mneuroth/PicoHomeComputer/Documentation/README.md

# Documentation of the PicoHomeComputer

Schematical diagram

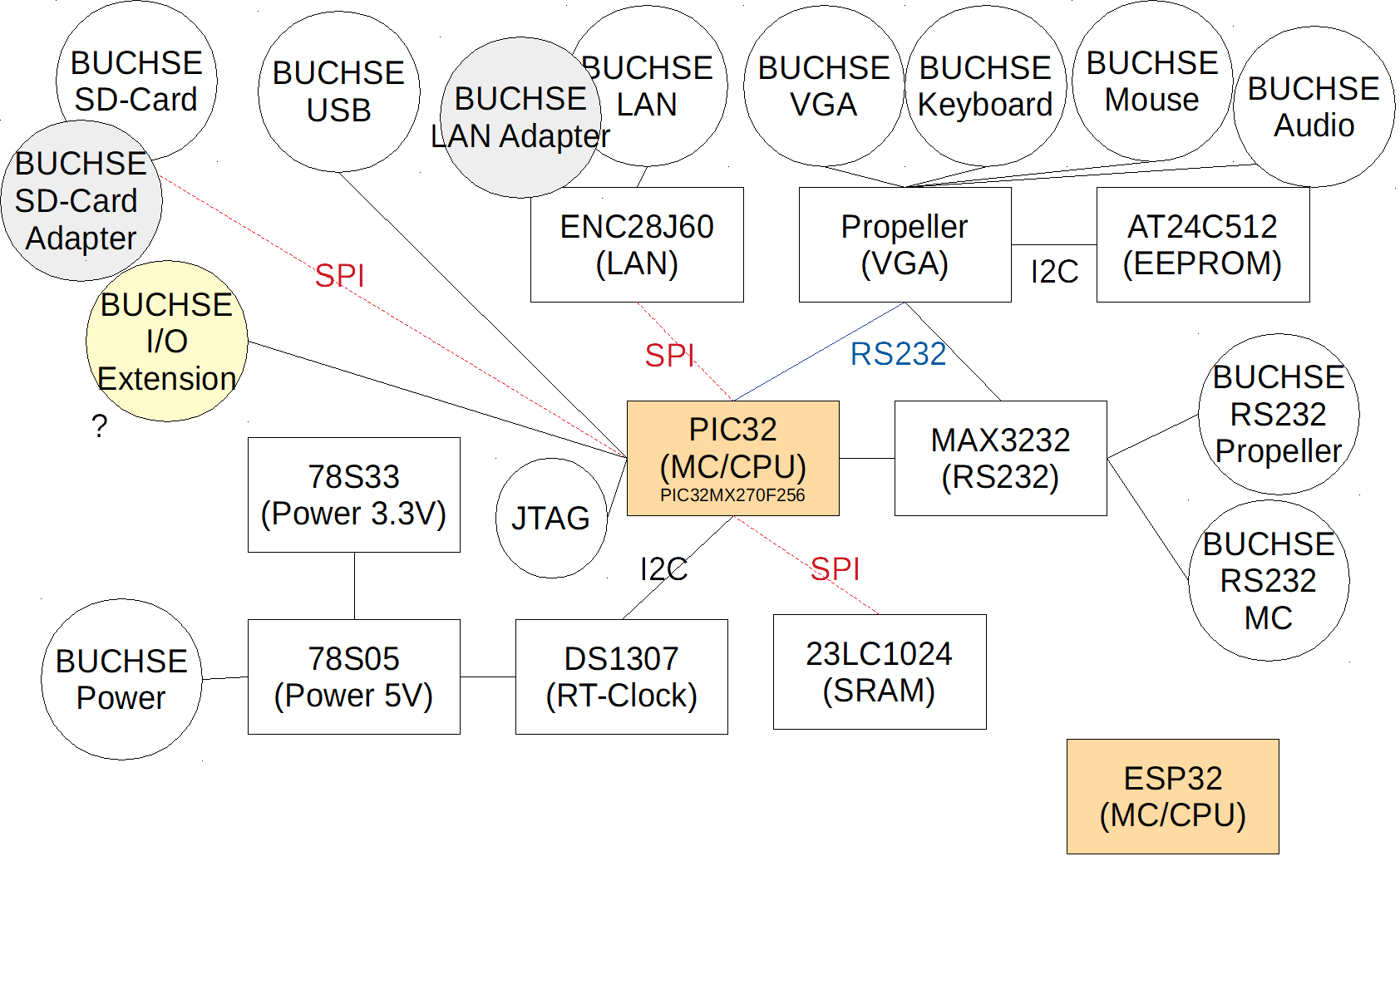
[picture p2: Documentation/BlockDiagramm.png]
BlockDiagram
