mneuroth/PicoHomeComputer/datasheets/LAN_Adapter_HunRun-06_Circuit.jpg

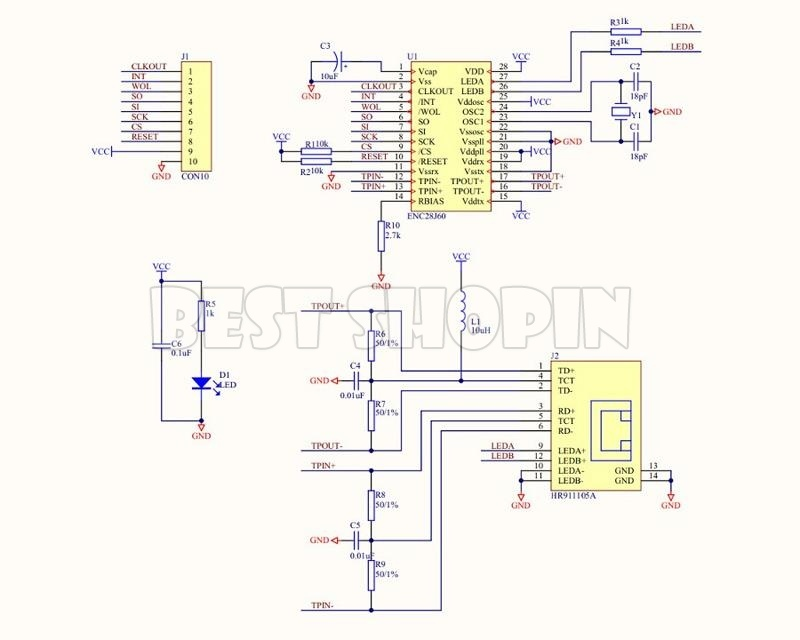
datasheets/LAN_Adapter_HunRun-06_Circuit.jpg
