mneuroth/PicoHomeComputer/datasheets/parallax_propeller_circuit_example.jpg

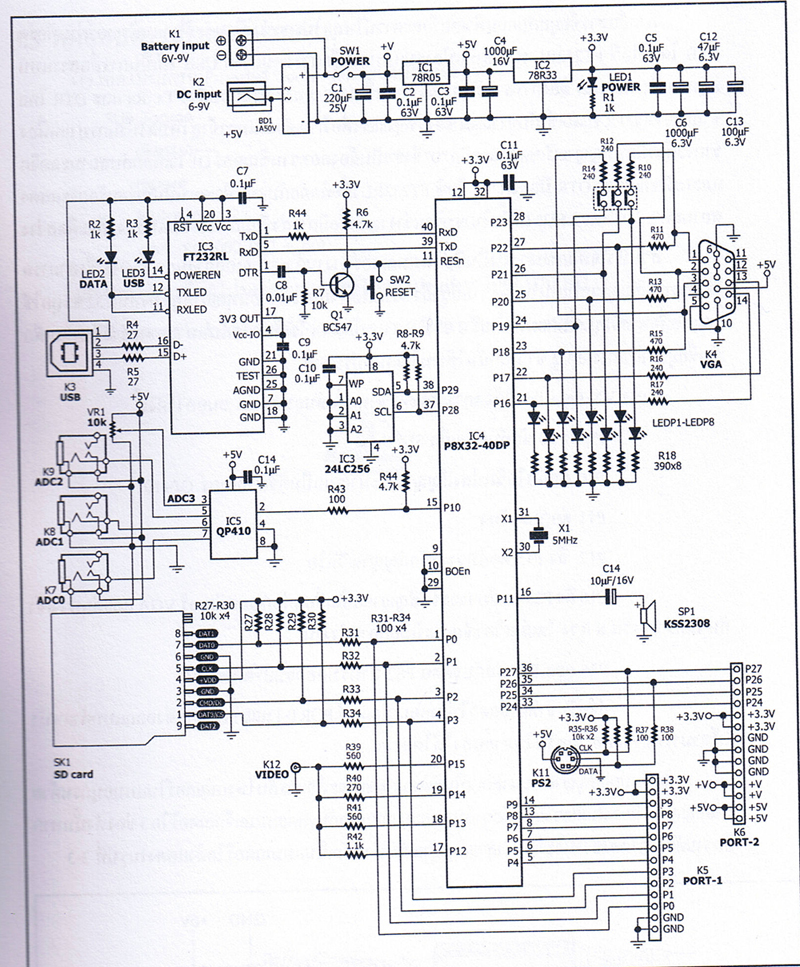
datasheets/parallax_propeller_circuit_example.jpg
