mneuroth/PicoHomeComputer/Documentation/BomRetroHomeComputer.ods

Stückliste Retro Home Computer
Bauteilbezeichnung | Bauteil Nr. | RS Components | Preis [€] | Digikey | Preis [€]
ENC28J60 |  | http://de.rs-online.com/web/p/ethernet-controller/6988981/ | 3,22 € | https://www.digikey.de/product-detail/de/microchip-technology/ENC28J60-SP/ENC28J60-SP-ND/765489 | 2,92 €
MAX232CPE |  | http://de.rs-online.com/web/p/line-transceiver/5405359/ | 3,40 € | https://www.digikey.de/product-detail/de/maxim-integrated/MAX232CPE-/MAX232CPE--ND/947834 | 2,95 €
PIC32MX270F256 |  | http://de.rs-online.com/web/p/mikrocontroller/8696123/ | 4,29 € | https://www.digikey.de/product-detail/de/microchip-technology/PIC32MX270F256B-I-SP/PIC32MX270F256B-I-SP-ND/4902630 | 3,81 €
P8X32A-D40 |  | http://de.rs-online.com/web/p/mikrocontroller/0405597/ | 7,08 € | https://www.digikey.de/product-detail/de/parallax-inc/P8X32A-D40/P8X32A-D40-ND/1136005 | 7,33 €
24LC256 |  | http://de.rs-online.com/web/p/speicherbausteine-eeprom/0454371/ | 0,87 € | https://www.digikey.de/product-detail/de/microchip-technology/24LC256-I-P/24LC256-I-P-ND/273431 | 0,77 €
DS1307+ |  | http://de.rs-online.com/web/p/echtzeituhren/5402726/ | 2,78 € | https://www.digikey.de/product-detail/de/maxim-integrated/DS1307-/DS1307--ND/956883 | 3,09 €
L78S05CV |  | http://de.rs-online.com/web/p/spannungs-linearregler/0633026/ | 0,87 € | https://www.digikey.de/product-detail/de/stmicroelectronics/L78S05CV/497-1468-5-ND/585989 | 0,62 €
UA78M33CKCS |  | http://de.rs-online.com/web/p/spannungs-linearregler/6616737/ | 0,49 € | https://www.digikey.de/product-detail/de/texas-instruments/UA78M33CKCS/296-21633-5-ND/1494026 | 0,84 €
23LC1024 |  |  |  | https://www.digikey.de/product-detail/de/microchip-technology/23LC1024-I-P/23LC1024-I-P-ND/3543083 | 2,24 €
DIN 6 Pol (Tastatur) |  |  |  | https://www.digikey.de/product-detail/de/cui-inc/MD2-60ST/CP-2267-ND/724796 | 1,45 € | https://www.conrad.de/de/mini-din-einbaubuchse-geschirmt-geschirmt-pole-6-assmann-wsw-inhalt-1-st-741797.html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 | 1,82 €
VGA Buchse |  | http://de.rs-online.com/web/p/sub-d-steckverbinder-leiterplatte/6927320/ | 3,98 € | https://www.digikey.de/product-detail/de/te-connectivity-amp-connectors/1-1734530-1/A35116-ND/1279829 | 1,82 €
 |  | http://de.rs-online.com/web/p/sub-d-steckverbinder-leiterplatte/7199110/ | 1,44 €
SD-Card Slot |  | http://de.rs-online.com/web/p/speicher-und-sim-karten-steckverbinder/1224349/ | 1,84 € | http://www.digikey.de/scripts/DkSearch/dksus.dll?Detail&itemSeq=228283914&uq=636306354258778756 | 1,10 € | http://de.rs-online.com/web/c/steckverbinder/usb-d-sub-und-computersteckverbinder/speicher-und-sim-karten-steckverbinder/ |  |  |  | http://de.rs-online.com/web/c/steckverbinder/usb-d-sub-und-computersteckverbinder/speicher-und-sim-karten-steckverbinder/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
 |  |  |  | http://www.digikey.de/scripts/DkSearch/dksus.dll?Detail&itemSeq=228282555&uq=636306354646642865
LAN Buchse (RJ45EM) |  | http://de.rs-online.com/web/p/rj-45-steckverbinder/0413403/ | 1,53 € | https://www.digikey.de/product-detail/de/assmann-wsw-components/A-2004-2-4-LP-FS-N-R/AE10386-ND/2183637 | 1,04 € | https://www.conrad.de/de/modulare-einbaubuchse-horizontal-na-grau-922647.html | 2,14 € | https://www.conrad.de/de/modulare-einbaubuchse-ohne-schirmlasche-buchse-gewinkelt-pole-8p8c-1421-2000-02-vernickelt-metall-bel-stewart-connec-745442.html | http://de.rs-online.com/web/c/steckverbinder/netzwerk-und-telekommunikations-steckverbinder/rj-45-steckverbinder/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
USB A Buchse |  | http://de.rs-online.com/web/p/usb-typ-a-steckverbinder/9097864/ | 2,52 € | http://www.digikey.de/scripts/DkSearch/dksus.dll?Detail&itemSeq=228282079&uq=636306349605998851 | 1,09 €
RS232 Buchse |  | http://de.rs-online.com/web/p/sub-d-steckverbinder-leiterplatte/6740827/ | 0,77 € | http://www.digikey.de/scripts/DkSearch/dksus.dll?Detail&itemSeq=228282602&uq=636306349762683779 | 0,71 € | http://de.rs-online.com/web/c/steckverbinder/usb-d-sub-und-computersteckverbinder/sub-d-steckverbinder-leiterplatte/
Audio Buchse |  |  |  | https://www.digikey.de/product-detail/de/cui-inc/SJ1-3535NG-GR/CP1-3535NG-GR-ND/2295993 | 1,14 € | https://www.conrad.de/de/klinken-steckverbinder-35-mm-buchse-einbau-horizontal-polzahl-4-stereo-schwarz-conrad-components-1-st-718732.html | 1,01 €
Power Buchse |  |  |  | https://www.digikey.de/product-detail/de/cui-inc/PJ-002A/CP-002A-ND/96962 | 0,55 €
 |  |  |  | https://www.digikey.de/product-detail/de/cui-inc/PJ-002B/CP-002B-ND/96965 | 0,55 €
Batterie Halter |  | http://de.rs-online.com/web/p/modular-batteriekontakte/7188472/ | 1,26 € | http://www.digikey.de/scripts/DkSearch/dksus.dll?Detail&itemSeq=228535804&uq=636308895731238261 | 1,32 € | http://de.rs-online.com/web/c/batterien/ladegeraete-batterien-zubehoer/batteriehalter-halterungen/
Quarz | 5 MHz | Propeller |  | https://www.digikey.de/product-detail/de/ecs-inc/ECS-50-18-4XEN/XC1738-ND/2213758 | 0,61 €
Quarz | 8 MHz ??? | PIC32 |  | https://www.digikey.de/product-detail/de/abracon-llc/ABL-8.000MHZ-B2/535-9062-ND/675257 | 0,30 €
Quarz | 25 MHz | Ethernet |  | https://www.digikey.de/product-detail/de/ecs-inc/ECS-250-20-46X/XC1764-ND/2676594 | 0,36 €
Quarz | 32 kHz | Echtzeituhr |  | https://www.digikey.de/product-detail/de/ecs-inc/ECS-.320-12.5-13X/XC1392-ND/827654 | 0,79 €
Quarz | 16 MHz |  |  | http://www.digikey.de/scripts/DkSearch/dksus.dll?Detail&itemSeq=228286355&uq=636306368866173937 | 0,36 €
Doppel Umschalter RS232 |  | https://www.conrad.de/de/schiebeschalter-30-vdc-01-a-1-x-einein-nkk-switches-ss12sdp2-1-st-704240.html |  | https://www.digikey.de/product-detail/de/e-switch/EG2201A/EG1905-ND/101732 | 0,73 €
https://www.e-switch.com/system/asset/product_line/data_sheet/119/EG.pdf
Buchse für Kaufplatine ?
JTG |  |  |  | https://www.digikey.de/product-detail/de/wurth-electronics-inc/61300611121/732-5319-ND/4846833 | 0,35 €
Pic-Kit
 | Stück
Sockel 40 Pin | 1 |  |  | https://www.digikey.de/product-detail/de/assmann-wsw-components/AR-40-HZL-TT/AE10018-ND/821772 | 1,95 €
Sockel 28 Pin | 2 |  |  | https://www.digikey.de/product-detail/de/assmann-wsw-components/AR-28-HZL-TT/AE10017-ND/821771 | 1,37 €
Socket 16 Pin | 1 |  |  | https://www.digikey.de/product-detail/de/assmann-wsw-components/AR-16-HZL-TT/AE10013-ND/821767 | 0,84 €
Sockel 8 Pin | 3 |  |  | https://www.digikey.de/product-detail/de/assmann-wsw-components/AR-08-HZL-TT/AE10011-ND/821765 | 0,46 €
10 kOhm |  |  |  | https://www.digikey.de/product-detail/de/stackpole-electronics-inc/CF14JT10K0/CF14JT10K0CT-ND/1830374
2.7 kOhm |  |  |  | https://www.digikey.de/product-detail/de/stackpole-electronics-inc/RNMF14FTC2K70/S2.7KCACT-ND/2617483
2.2 kOhm |  |  |  | https://www.digikey.de/product-detail/de/stackpole-electronics-inc/RNMF14FTC2K20/S2.2KCACT-ND/2617481
470 Ohm |  |  |  | https://www.digikey.de/product-detail/de/stackpole-electronics-inc/RNF14FTD470R/RNF14FTD470RCT-ND/1975003
240 Ohm |  |  |  | https://www.digikey.de/product-detail/de/stackpole-electronics-inc/RNMF14FTC240R/S240CACT-ND/2617474
220 Ohm |  |  |  | https://www.digikey.de/product-detail/de/stackpole-electronics-inc/RNMF14FTC220R/S220CACT-ND/2617470
100 Ohm |  |  |  | https://www.digikey.de/product-detail/de/stackpole-electronics-inc/RNF14FTD100R/RNF14FTD100RCT-ND/1974980
47 Ohm |  |  |  | https://www.digikey.de/product-detail/de/stackpole-electronics-inc/RNMF14FTC47R0/S47CACT-ND/2617508 | 0,07 €
100 uF |  |  |  | https://www.digikey.de/product-detail/de/wurth-electronics-inc/860020473008/732-8825-1-ND/5728770 | 0,14 €
10 uF | 1 |  |  | https://www.digikey.de/product-detail/de/wurth-electronics-inc/860010472002/732-8625-1-ND/5728581 | 0,11 €
100 nF |  |  |  | http://www.digikey.de/scripts/DkSearch/dksus.dll?Detail&itemSeq=228644147&uq=636310612405245830 | 0,21 €
22 pF | 2 |  |  | http://www.digikey.de/scripts/DkSearch/dksus.dll?Detail&itemSeq=228643736&uq=636310608511097744 | 0,27 €
18 pF | 2 |  |  | http://www.digikey.de/scripts/DkSearch/dksus.dll?Detail&itemSeq=228642794&uq=636310604061180789 | 0,19 €
10 uH | 1 |  |  | https://www.digikey.de/product-detail/de/epcos-tdk/B78108T1103K/495-5574-1-ND/4245873 | 0,37 €
Diode 1N4001 | 1 |  |  | https://www.digikey.de/product-detail/de/micro-commercial-co/1N4001-TP/1N4001-TPMSCT-ND/773688 | 0,10 €
LED | 2
 |  |  | 36,33 € |  | 44,92 €
