mneuroth/PicoHomeComputer/board/RetroHomeComputer_V1.0_PCB.PDF

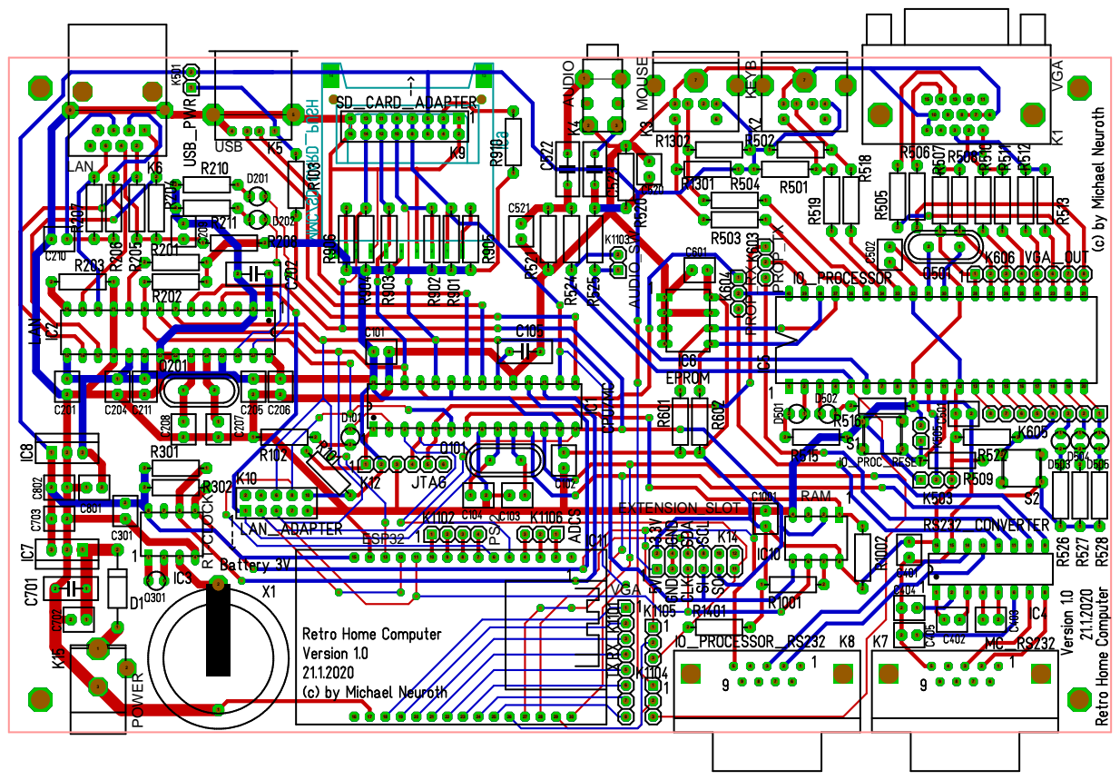
[picture p7: page 1]
VGAAUDIO_SW; EXTENSION_SLOT; AUDIO; ESP32; MOUSE; PROP_TX; PROP_RX; RAM; USB; POWER; LAN; KEYB; VGA; RT-CLOCK
