mneuroth/PicoHomeComputer/board/RetroHomeComputer_V1.0_SCH.PDF

## Bemerkung: R103 gibt es nur aus Layout Gründen !

TODO: Bemerkung: keine generischen Stecker verwenden --> einfach Option ESP32 oder PIC32&Propeller, kein ESP32&Propeller

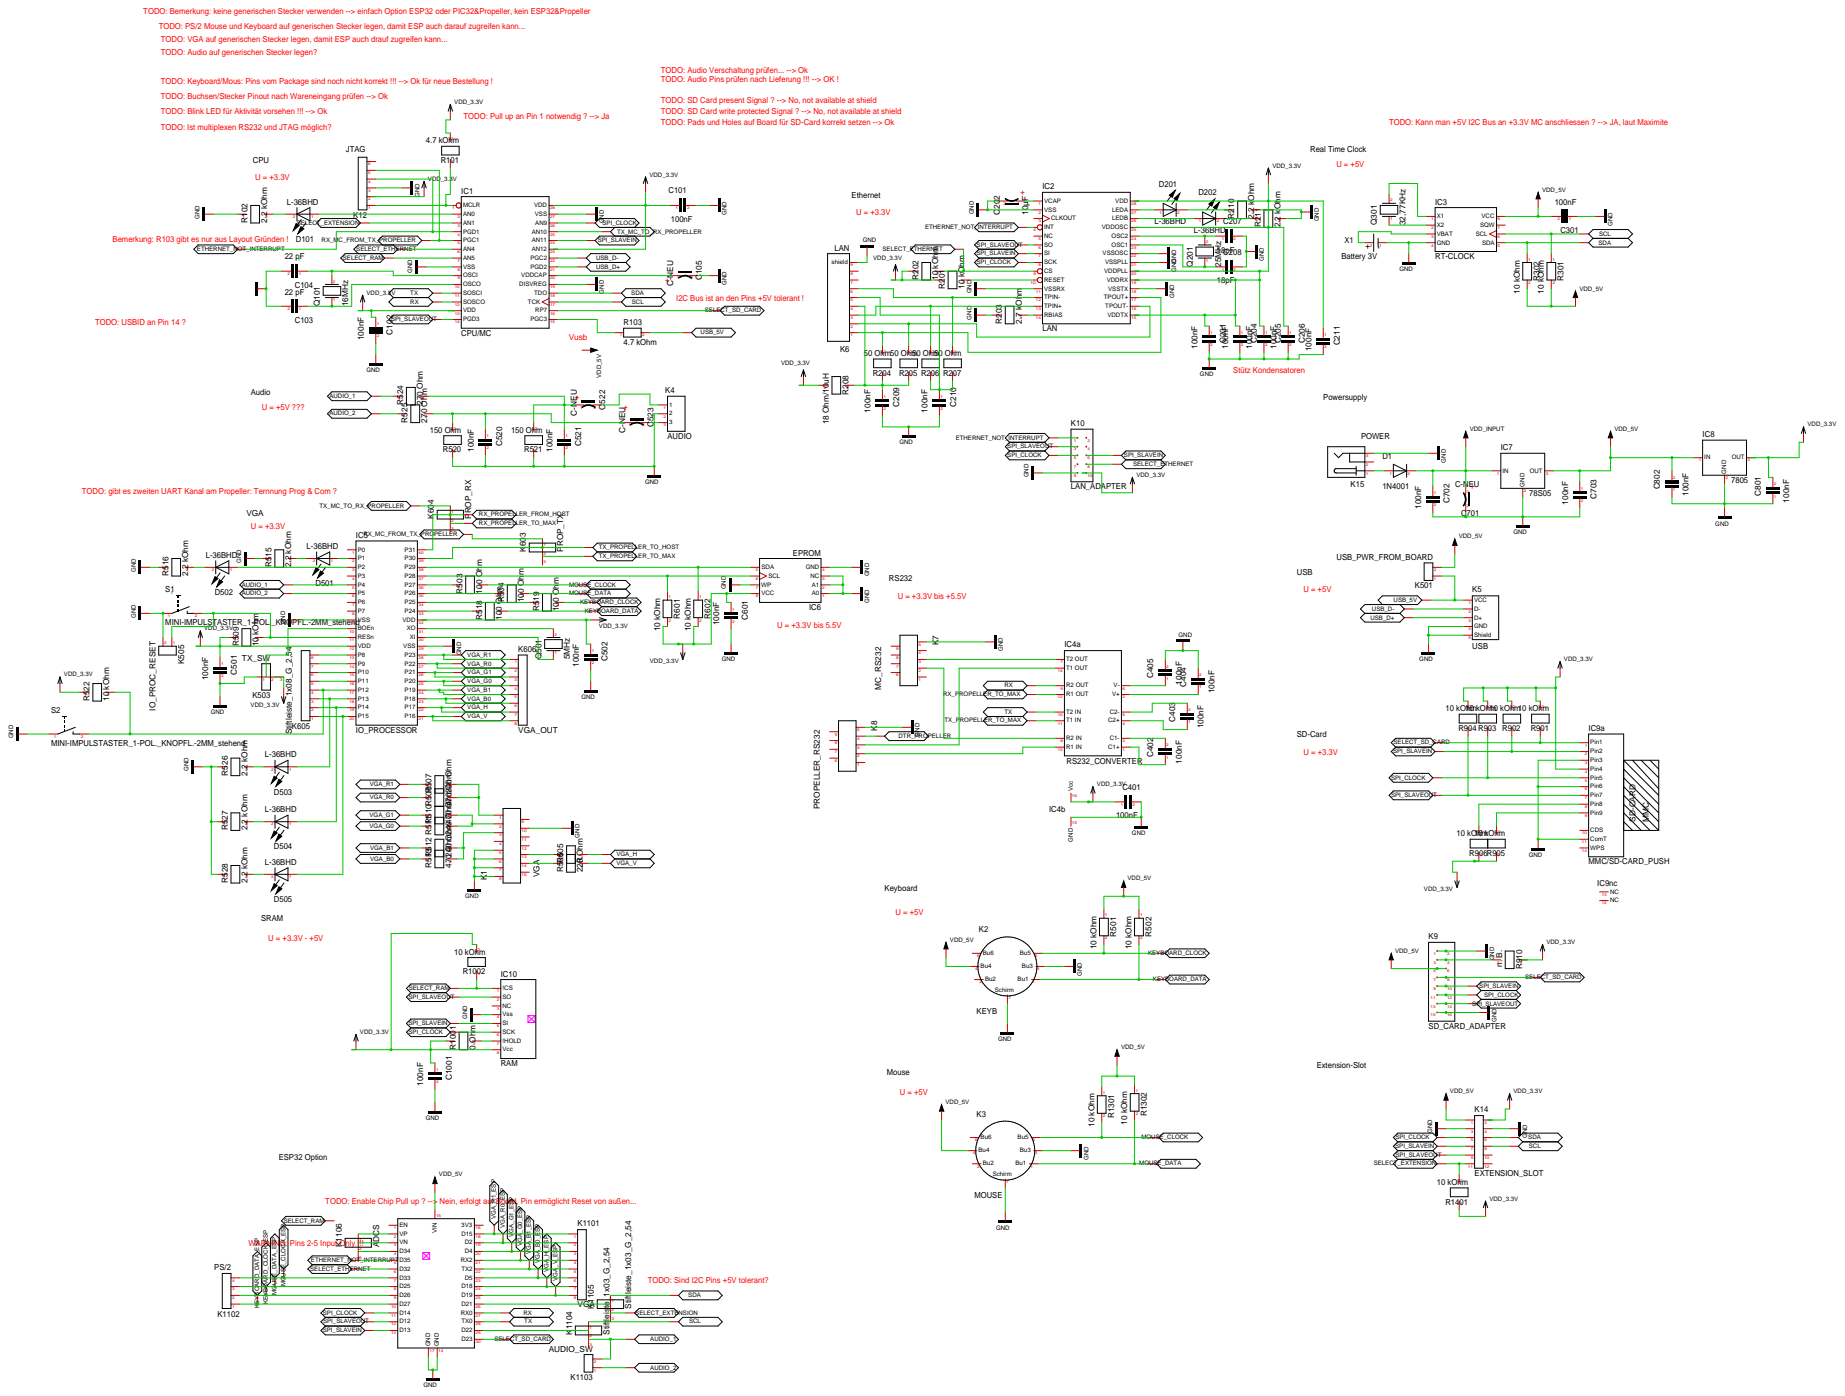
[picture p8: page 1]

TODO: PS/2 Mouse und Keyboard auf generischen Stecker legen, damit ESP auch darauf zugreifen kann...
TODO: VGA auf generischen Stecker legen, damit ESP auch drauf zugreifen kann...
TODO: Audio auf generischen Stecker legen?

TODO: Audio Verschaltung prüfen... --> Ok
TODO: Audio Pins prüfen nach Lieferung !!! --> OK !

TODO: Keyboard/Mous: Pins vom Package sind noch nicht korrekt !!! --> Ok für neue Bestellung !
TODO: Buchsen/Stecker Pinout nach Wareneingang prüfen --> Ok
TODO: Pull up an Pin 1 notwendig ? --> Ja TODO: Blink LED für Aktivität vorsehen !!! --> Ok
TODO: Ist multiplexen RS232 und JTAG möglich?

TODO: SD Card present Signal ? --> No, not available at shield
TODO: SD Card write protected Signal ? --> No, not available at shield
TODO: Pads und Holes auf Board für SD-Card korrekt setzen --> Ok

TODO: Kann man +5V I2C Bus an +3.3V MC anschliessen ? --> JA, laut Maximite

I2C Bus ist an den Pins +5V tolerant !

TODO: USBID an Pin 14 ?

TODO: gibt es zweiten UART Kanal am Propeller: Ternnung Prog & Com ?

TODO: Enable Chip Pull up ? --> Nein, erfolgt auf Board, Pin ermöglicht Reset von außen...

KEYBOARD_CLOCK_ESP
WARNING: Pins 2-5 Input Only !!!

TODO: Sind I2C Pins +5V tolerant?
