mneuroth/PicoHomeComputer/PIC32/ulisp/ulisp_pic32.X/ulisp_pic32.h

/* 
 * File:   ulisp_pic32.h
 * Author: micha
 *
 * Created on 9. Januar 2020, 21:43
 */

#ifndef ULISP_H
#define	ULISP_H

#ifdef __cplusplus
extern "C" {
#endif
    
void ulisp_setup();
void ulisp_loop();

#ifdef __cplusplus
}
#endif

#endif	/* ULISP_H */
