mneuroth/PicoHomeComputer/(commit log)

2019-11-26 Initial checkin of the board circuit diagram (from 26.9.2017)
2019-12-08 Update circuit diagram
2019-12-10 Circuit diagram nearly finished
2019-12-26 First version of layout for home computer board
2019-12-27 Improved board layout, fixed some small bugs
2019-12-27 Fixed audio connector pins and updates
2020-01-03 Improved and simplified board layout, synchronized pinout of PIC32 with microchip ide (MCC). Use SPI2 instead of SPI1 because of remaping of pins (IDC conflicts with SELECT_xyz because input is neede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
2020-01-10 Update pin configuration for RetroHomeCompter board
2020-01-10 Fixed line feed encoding (Mac --> Windows)
    [ulisp_pic32.cpp]
2020-01-10 Improved layout, added reset button for propeller
2020-01-10 Optimized board layout, made wires and elements more symmetric
2020-01-12 Updated pin configuration for pic32 to synchronize with board
2020-01-12 Renamed pin signals
2020-01-12 Added pin strip for vga signals after propeller chip (shortcut from ESP32)
2020-01-13 Improved layout, optimized labels and added capacitor for lan chip to support power
2020-01-15 Updated board layout, added strip pins to enable and disable USB 5V from connector
2020-01-15 Improved board layout and added K503
2020-01-18 Minor improvements of board layout, improved labels
2020-01-19 Updated layout, addes 3 LEDs and 1 switch at io processor
2020-01-21 Final layout of board for version 1.0
2020-02-07 Switched to primary oscillator --> now the baudrate is as expected
    [main.c]
2020-02-08 Checked in original uLisp implementation for arm (from 11. january 2020 https://github.com/technoblogy/ulisp-arm/commits/master/ulisp-arm.ino)
2020-02-08 Fixed problem with serial.read() return -1 if no character is available, like in Arduino documentation needed, this solves the problem with entering expressions via RS232 but needing many CR/LFs
    [ulisp_pic32.cpp]
2020-02-10 Implemented delay() and millis() functions (with counter and timer), changed frequency which results in a problem with RS232 communication (bad baudrate)
    [main.c]
2020-02-11 Implemented millis() with timer, use delay_us() for delay function, set external oscillator to 8MHz
    [main.c]
2020-02-21 Added copy of version 1.0 of PicoHomeComputer board
2020-02-21 Added schematic and board pdf export for board version 1.0
2020-02-21 Added virtual model of board V 1.0
2020-02-21 Added readme for the board directory
2020-02-21 Changed version string from 1.0 to 1.1, updated date, renamed board into Pico Home Computer, added capacitor C106 at pin 23 of PIC32, modified value of R102 from 2.2 kOhm to 1 kOhm
2020-02-21 Updaetd dokumentation for arduino pin mapping
2020-02-21 Added documentation to patch chipKIT plugin for ArduinoIDE to support PicoHomeComputer, added initial board_data for arduino pinout using the HelvePic32a data
2020-02-21 Modified pinout definition files for PicoHomeComputer board
2020-02-21 Update documentation for programming via ArduinoIDE
2020-02-22 Switched to SPI2 implementation, because this pins are used in the PicoHomeComputer board for SPI communication
2020-02-23 Updated SPI configuration for PicoHomeComputer
2020-02-23 Updated configuration for SPI bus and added some SPI test code
2020-02-23 Bug: SDO means Serial Data Out and not Slave Data Out --> MISO and MOSI are interchanged. MOSI in circuit can be changed to MISO on pin RB13
2020-03-13 Added link to propeller libraries
2020-03-13 Added link to image of PicoHomeComputer board in README.md
2020-03-13 Added BOM and block diagram as documentation
    [BomRetroHomeComputer.ods]
2020-03-13 Updated schematical diagram and added README.md with image reference
2020-03-27 Updated README.md for the io processor firmware (added reference to propeller libraries)
2020-04-03 Added README.md for propeller firmware
2020-04-03 First firmware version of propeller to communicate with PIC32 uLisp
2020-04-04 Implemented differend modes: terminal, shell, solo; implemented #help and #clr commands, implemented simple command buffer for last command; cleaned up source code; fixed synchronized problem with x-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
    [PicoHomeComputer_IOProcessor.spin]
2020-04-04 Bugfix: update iKeyboardCommandBufferPos after swapping with last command
    [PicoHomeComputer_IOProcessor.spin]
2020-04-05 Decresed speed of mouse, increased speed of keyboard; Bugfix: move for backspace only to the beginning of the editing position
    [PicoHomeComputer_IOProcessor.spin]
2020-04-09 Improved robustness of communication with io processor: reduced baudrate to 19200 baud because of receive buffer overrun in propeller; experimented with other rs232 drivers; added info command
2020-04-10 Added support for better shell input: autowrap lisp brackets possible
2020-04-11 Improved support for editing command (allow cursor left, cursor right, delete, insert); synchronize cursor with insert modus
2020-04-13 Improved support for editing commands: implemented list as command buffer; implemented commands #savescreen and #restorescreen; implemented handling of ESC and DEL key; implemented handling for curso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
2020-04-13 Bugfix for backspace handling; improved source code for key handling
    [PicoHomeComputer_IOProcessor.spin]
2020-04-15 Improvements, bugfixes and support to set cursor
    [PicoHomeComputer_IOProcessor.spin]
2021-05-23 Update documentation to integrate chipKIT support into ArduinoIDE
2021-05-23 Updated documentation, added short history of the PicoHomeComputer board, added list of problems with board
2022-01-30 Updated documentation about chipKIT support in Arduino IDE
